ehajo/arcade-machine/Controller-Tennis/CAD/step/Unterteil.stp

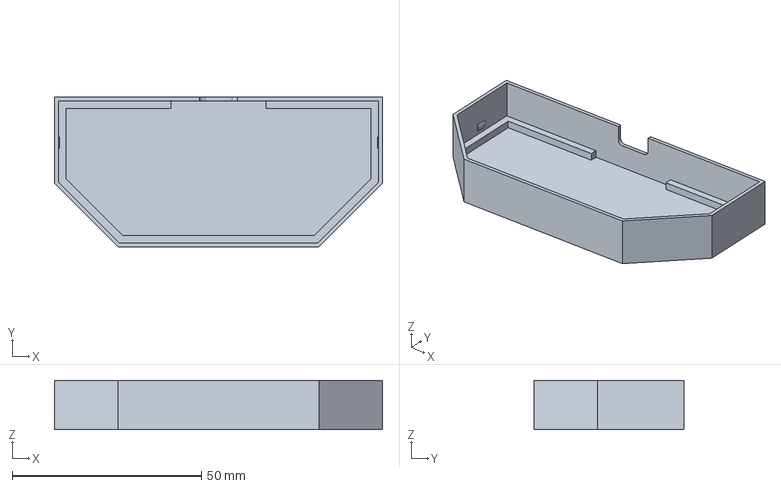
[picture p1: CAD file, 2026-05-15]
Controller-Tennis/CAD/step/Unterteil.stp
86.6 x 39.6 x 13.0 mm
