ehajo/arcade-machine/Controller-Tennis/PCB/controller-tennis/controller-tennis.step

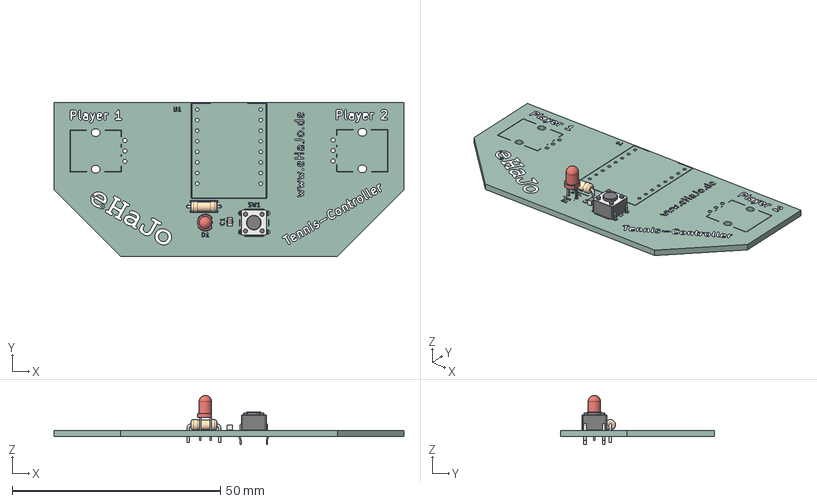
[picture p2: CAD file, 2026-02-06]
Controller-Tennis/PCB/controller-tennis/controller-tennis.step
84.0 x 37.0 x 11.8 mm
R_Axial_DIN0207_L6.3mm_D2.5mm_P7.62mm_Horizontal
C_0805_2012Metric
SW_PUSH_6mm
LED_D3.0mm
controller-tennis_silkscreen
controller-tennis_PCB
