ehajo/arcade-machine/Machine/CAD/step/Arcade.3mf

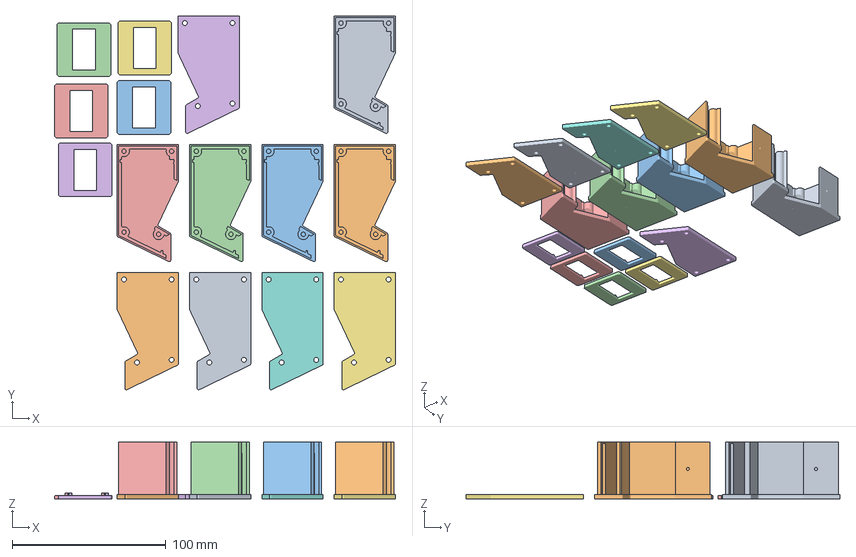
[picture p3: CAD file, 2026-05-20]
Machine/CAD/step/Arcade.3mf
222.1 x 243.4 x 37.0 mm
Arcade_base.stp x 5
Arcade_right.stp x 5
Bildschirm.stp x 5
