ehajo/arcade-machine/Controller-Tennis/CAD/step/knob.stp

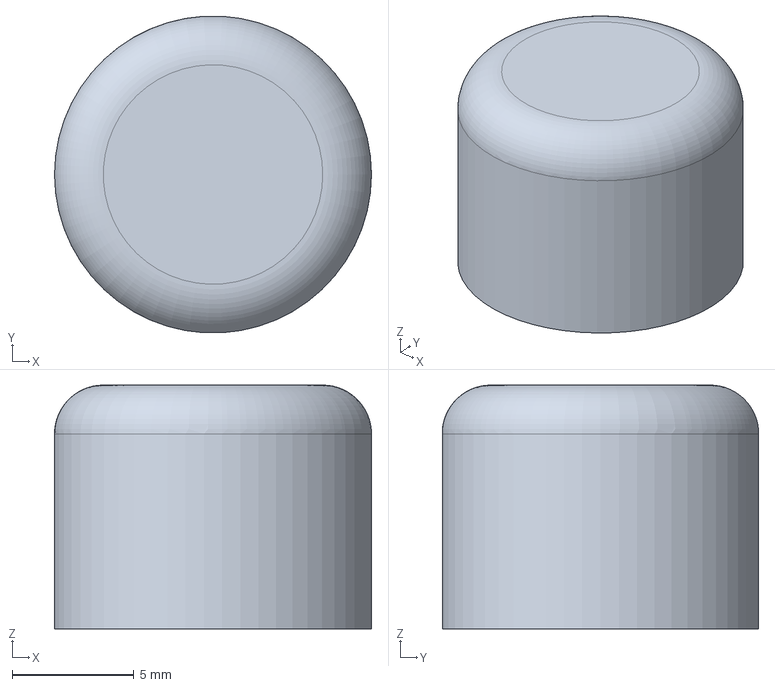
[picture p4: CAD file, 2026-05-15]
Controller-Tennis/CAD/step/knob.stp
13.0 x 13.0 x 10.0 mm
