ehajo/arcade-machine/Machine/CAD/step/Arcade_right.stp

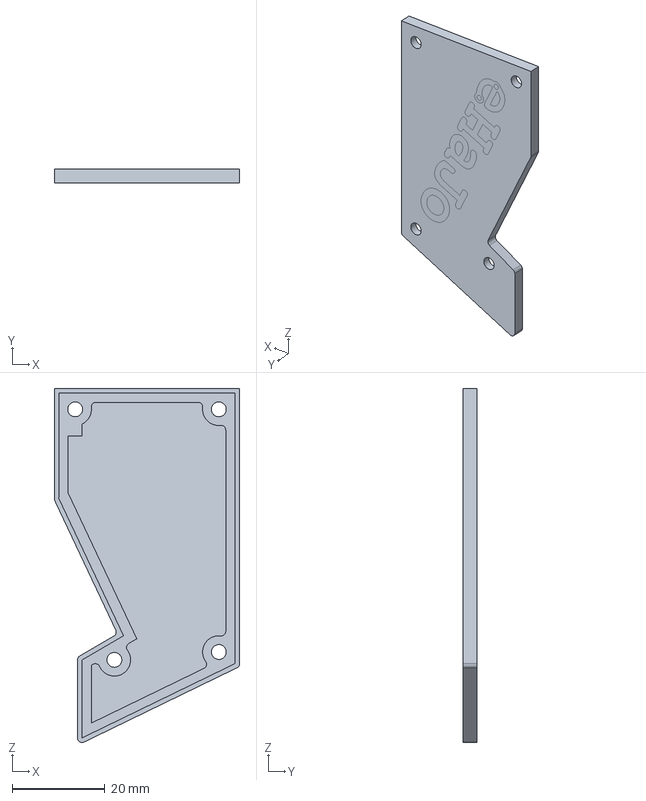
[picture p5: CAD file, 2026-05-15]
Machine/CAD/step/Arcade_right.stp
40.0 x 3.00 x 76.4 mm
