ehajo/arcade-machine/Controller-Tennis/CAD/step/Deckel.stp

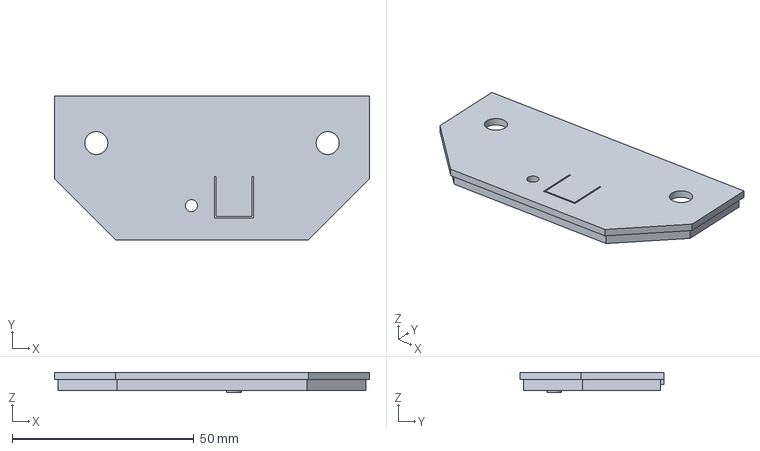
[picture p6: CAD file, 2026-05-15]
Controller-Tennis/CAD/step/Deckel.stp
86.6 x 39.6 x 5.60 mm
