ehajo/arcade-machine/Machine/CAD/step/Bildschirm.stp

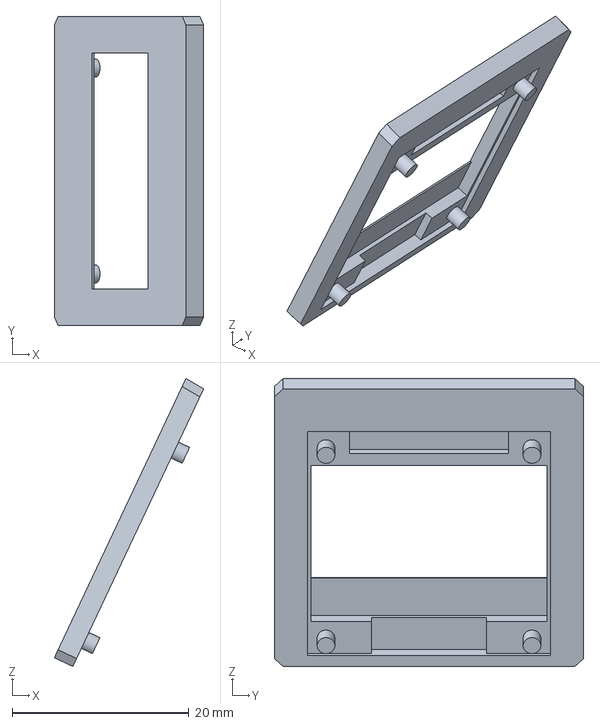
[picture p7: CAD file, 2026-05-15]
Machine/CAD/step/Bildschirm.stp
16.9 x 35.0 x 32.6 mm
