ehajo/arcade-machine/Controller-Tennis/CAD/step/tennis.3mf

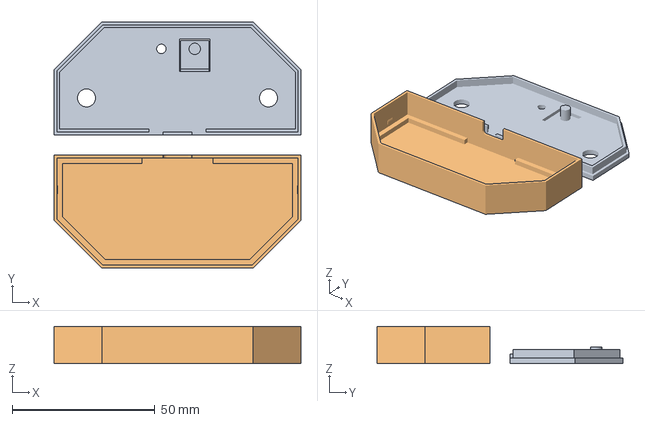
[picture p8: CAD file, 2026-05-15]
Controller-Tennis/CAD/step/tennis.3mf
86.6 x 86.3 x 13.0 mm
Deckel.stp
Unterteil.stp
