ehajo/arcade-machine/Machine/CAD/step/Arcade_base.stp

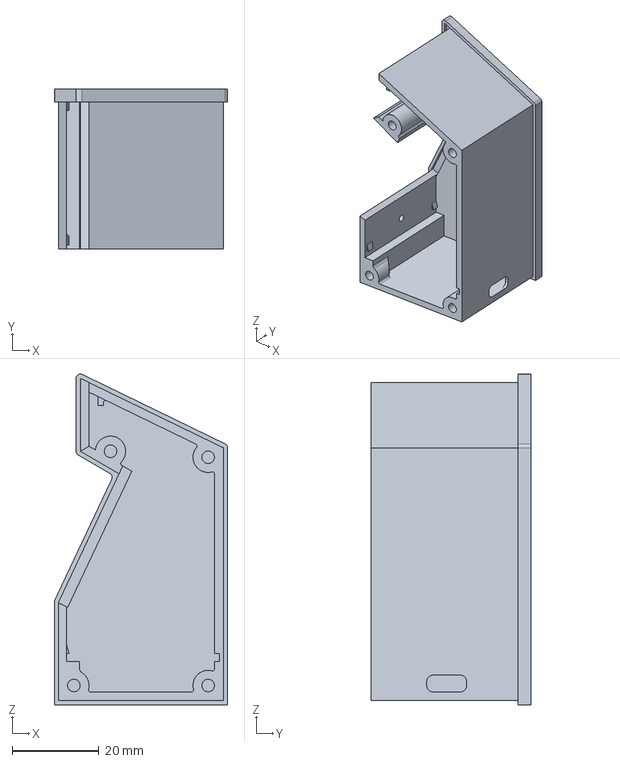
[picture p9: CAD file, 2026-05-15]
Machine/CAD/step/Arcade_base.stp
40.0 x 37.0 x 76.4 mm
