ehajo/arcade-machine/Machine/CAD/step/Beschriftung_blank.stp

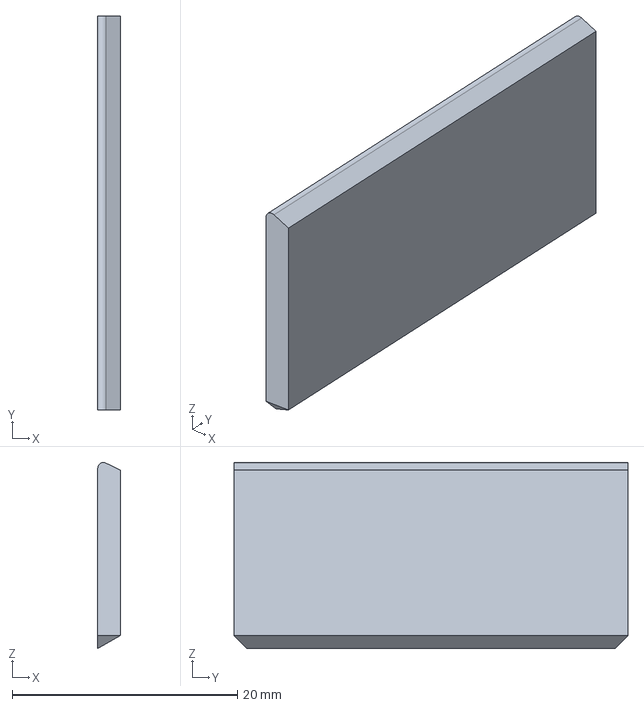
[picture p10: CAD file, 2026-05-15]
Machine/CAD/step/Beschriftung_blank.stp
2.00 x 35.0 x 16.5 mm
