ehajo/arcade-machine/Machine/CAD/step/Beschriftung.stp

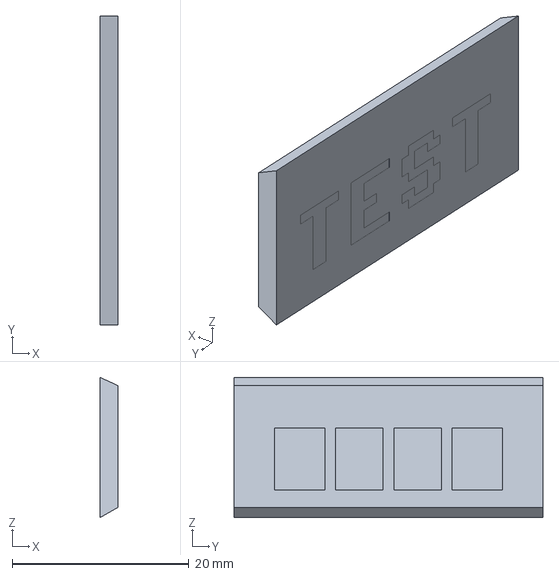
[picture p11: CAD file, 2026-02-06]
Machine/CAD/step/Beschriftung.stp
2.00 x 35.0 x 15.9 mm
