ehajo/arcade-machine/Machine/CAD/step/Beschriftung_test.stp

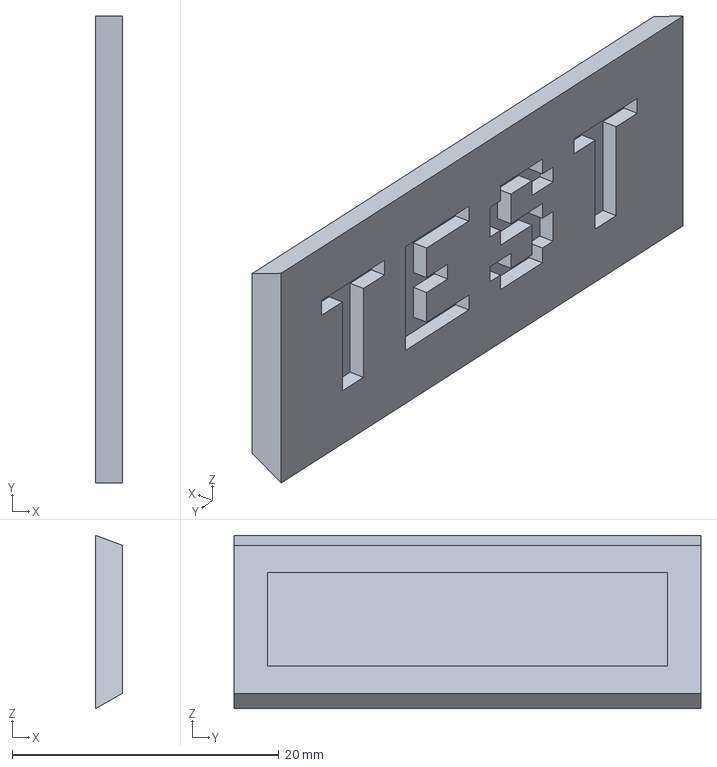
[picture p12: CAD file, 2026-02-06]
Machine/CAD/step/Beschriftung_test.stp
2.00 x 35.0 x 13.0 mm
