ehajo/arcade-machine/(list of files, cad)

Other CAD files:
Machine/CAD/step/Beschriftung_HaJo.stp
Machine/CAD/step/Beschriftung_ehajo.stp
Machine/CAD/step/Beschriftung_p1p2.stp
Machine/CAD/step/Beschriftung_diffus.stp
Machine/CAD/step/Beschriftung_ePNG.stp
Machine/CAD/step/Beschriftung_GNOP.stp
