ehajo/arcade-machine/Machine/PCB/arcade-pcb/arcade-pcb.kicad_pcb

## KiCad design Machine/PCB/arcade-pcb/arcade-pcb.kicad_pcb (2026-05-15)

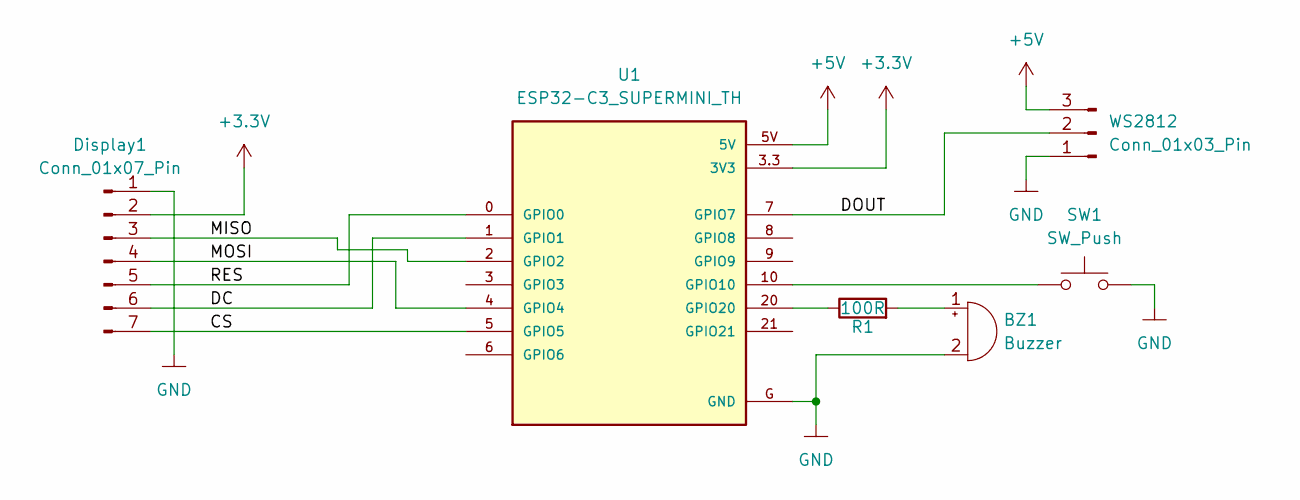
[picture p13: schematic arcade-pcb.kicad_sch]

Parts:
BZ1: Buzzer; Buzzer_12x9.5RM7.6
Display1: Conn_01x07_Pin; PinHeader_1x07_P1.27mm_Vertical_hand
R1: 100R; R_Axial_DIN0207_L6.3mm_D2.5mm_P7.62mm_Horizontal
SW1: SW_Push; SW_Tactile_SPST_Angled_PTS645Vx39-2LFS
U1: ESP32-C3_SUPERMINI_TH; MODULE_ESP32-C3_SUPERMINI_SMD
WS2812: Conn_01x03_Pin; PinHeader_1x03_P2.54mm_Vertical

Connections:
+3.3V: Display1.2, U1.3.3 (3V3)
+5V: U1.5V, WS2812.3
/CS: Display1.7, U1.5 (GPIO5)
/DC: Display1.6, U1.1 (GPIO1)
/DOUT: U1.7 (GPIO7), WS2812.2
/MISO: Display1.3, U1.2 (GPIO2)
/MOSI: Display1.4, U1.4 (GPIO4)
/RES: Display1.5, U1.0 (GPIO0)
GND: BZ1.2 (-), Display1.1, SW1.2, U1.G (GND), WS2812.1
unnamed: BZ1.1 (+), R1.2
unnamed: SW1.1, U1.10 (GPIO10)
unnamed: R1.1, U1.20 (GPIO20)

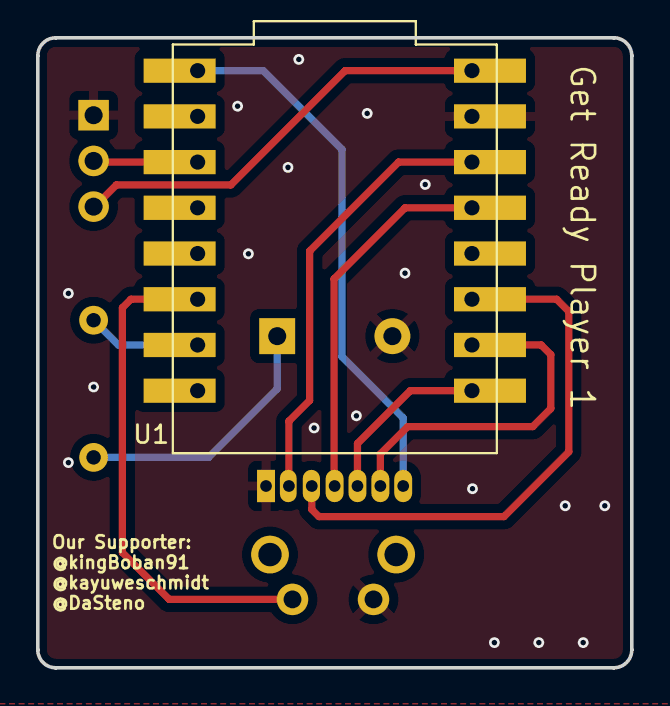
[picture p14: board arcade-pcb.kicad_pcb from above]

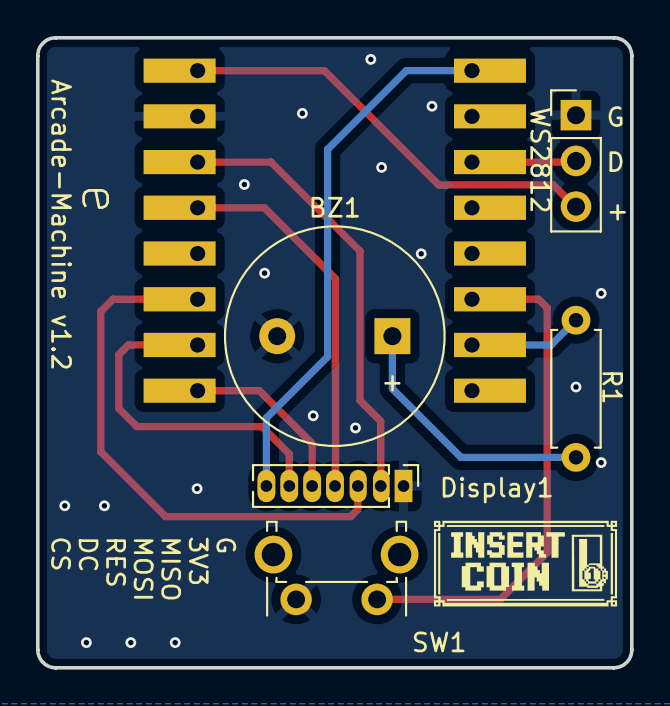
[picture p15: board arcade-pcb.kicad_pcb from below]

Board: 2 copper layers, 33.0 x 35.0 mm, 6 parts (5 on the bottom side), 12 nets.
