ehajo/arcade-machine/Controller-Standard/PCB/controller-standard/controller-standard.kicad_pcb

## KiCad design Controller-Standard/PCB/controller-standard/controller-standard.kicad_pcb (2026-03-03)

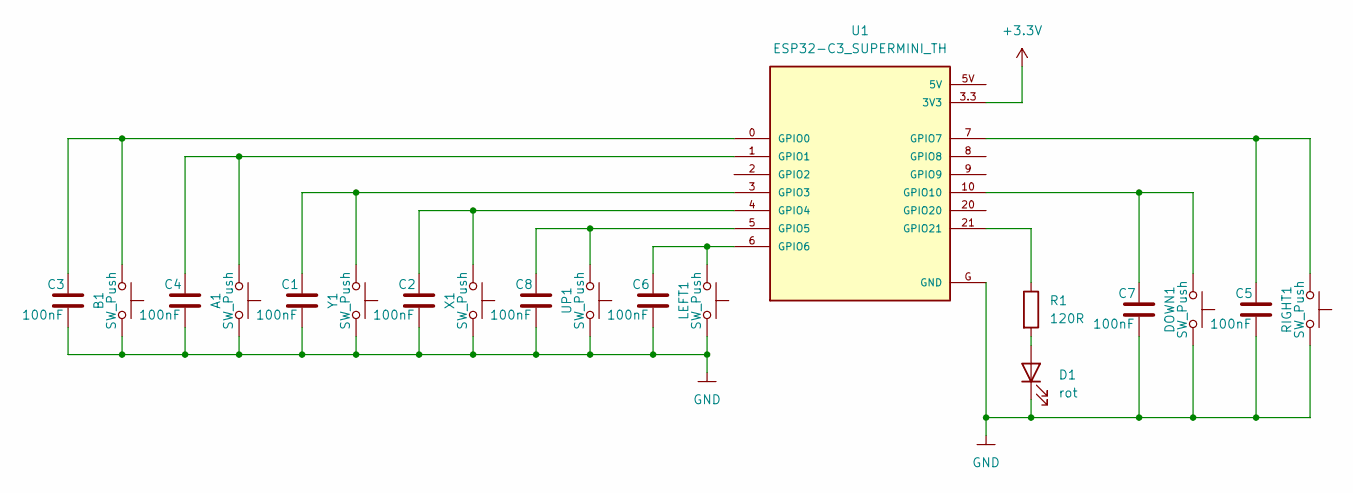
[picture p16: schematic controller-standard.kicad_sch]

Parts:
A1: SW_Push; SW_PUSH_6mm_H5mm
B1: SW_Push; SW_PUSH_6mm_H5mm
C1, C2, C3, C4, C5, C6, C7, C8: 100nF; C_0805_2012Metric_Pad1.18x1.45mm_HandSolder
D1: rot; LED_D3.0mm
DOWN1: SW_Push; SW_PUSH_6mm_H5mm
LEFT1: SW_Push; SW_PUSH_6mm_H5mm
R1: 120R; R_Axial_DIN0207_L6.3mm_D2.5mm_P7.62mm_Horizontal
RIGHT1: SW_Push; SW_PUSH_6mm_H5mm
U1: ESP32-C3_SUPERMINI_TH; MODULE_ESP32-C3_SUPERMINI_SMD
UP1: SW_Push; SW_PUSH_6mm_H5mm
X1: SW_Push; SW_PUSH_6mm_H5mm
Y1: SW_Push; SW_PUSH_6mm_H5mm

Connections:
+3.3V: U1.3.3 (3V3)
GND: A1.2, B1.2, C1.2, C2.2, C3.2, C4.2, C5.2, C6.2, C7.2, C8.2, D1.1 (K), DOWN1.2, LEFT1.2, RIGHT1.2, U1.G (GND), UP1.2, X1.2, Y1.2
unnamed: D1.2 (A), R1.2
unnamed: B1.1, C3.1, U1.0 (GPIO0)
unnamed: A1.1, C4.1, U1.1 (GPIO1)
unnamed: C1.1, U1.3 (GPIO3), Y1.1
unnamed: C2.1, U1.4 (GPIO4), X1.1
unnamed: C8.1, U1.5 (GPIO5), UP1.1
unnamed: C6.1, LEFT1.1, U1.6 (GPIO6)
unnamed: C5.1, RIGHT1.1, U1.7 (GPIO7)
unnamed: C7.1, DOWN1.1, U1.10 (GPIO10)
unnamed: R1.1, U1.21 (GPIO21)

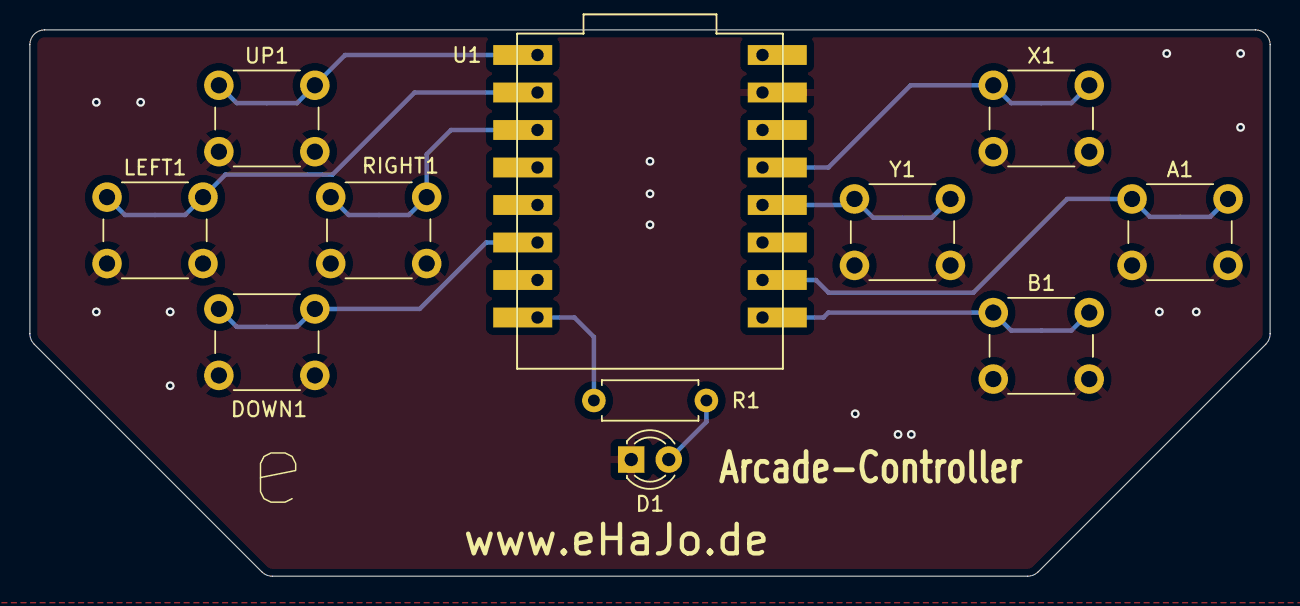
[picture p17: board controller-standard.kicad_pcb from above]

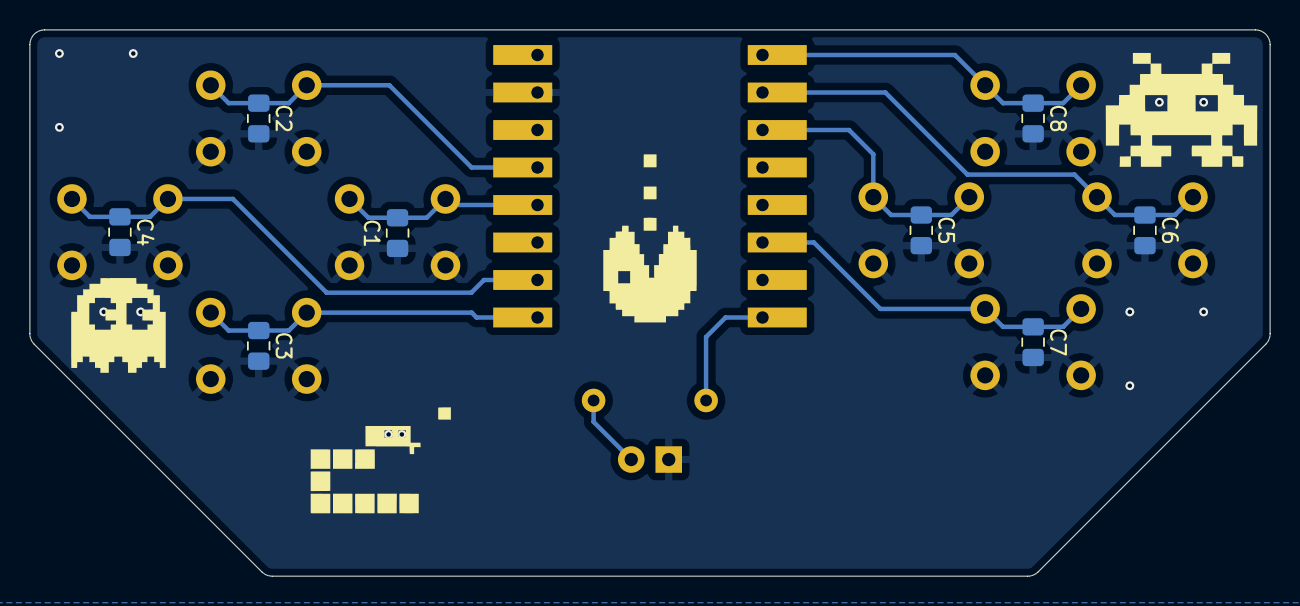
[picture p18: board controller-standard.kicad_pcb from below]

Board: 2 copper layers, 84.0 x 37.0 mm, 19 parts (8 on the bottom side), 11 nets.
