ehajo/arcade-machine/Controller-Tennis/PCB/controller-tennis/controller-tennis.kicad_pcb

## KiCad design Controller-Tennis/PCB/controller-tennis/controller-tennis.kicad_pcb (2026-03-03)

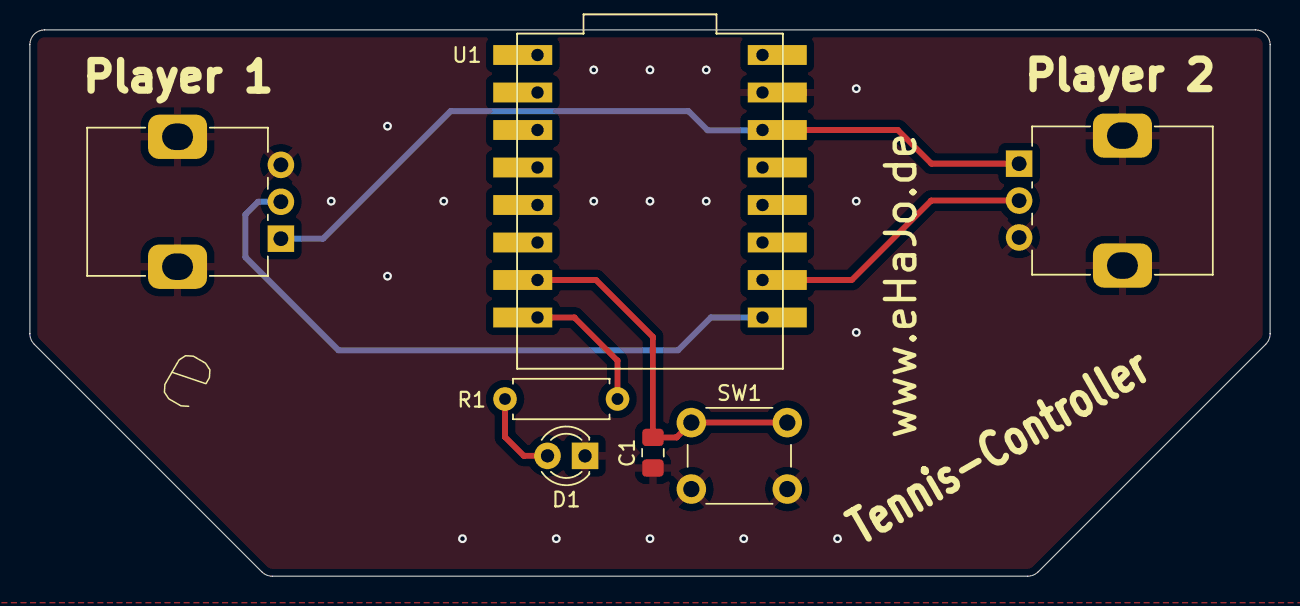
[picture p19: board controller-tennis.kicad_pcb from above]

Board: 2 copper layers, 84.0 x 37.0 mm, 7 parts (0 on the bottom side), 7 nets.

Parts:
C1: 100nF; C_0805_2012Metric_Pad1.18x1.45mm_HandSolder
D1: rot; LED_D3.0mm
Player 1, Player 2: 10k; Potentiometer_Alps_RK09K_Single_Vertical
R1: 120R; R_Axial_DIN0207_L6.3mm_D2.5mm_P7.62mm_Horizontal
SW1: SW_Push; SW_PUSH_6mm
U1: ESP32-C3_SUPERMINI_TH; MODULE_ESP32-C3_SUPERMINI_SMD

Connections:
+3.3V: Player 1.1, Player 2.1, U1.3.3 (3V3)
GND: C1.2, D1.1 (K), Player 1.3, Player 1.MP (MountPin), Player 2.3, Player 2.MP (MountPin), SW1.2, U1.G (GND)
unnamed: D1.2 (A), R1.2
unnamed: Player 1.2, U1.0 (GPIO0)
unnamed: Player 2.2, U1.1 (GPIO1)
unnamed: C1.1, SW1.1, U1.20 (GPIO20)
unnamed: R1.1, U1.21 (GPIO21)
