ehajo/arcade-machine/Machine/Software/elektronik-attack/elektronik-attack.ino

#include <Arduino.h>
#include <stdint.h>
#include <math.h>
#include <string.h>

#include <SPI.h>
#include <Adafruit_GFX.h>
#include <Adafruit_SSD1306.h>
#include <Adafruit_NeoPixel.h>

// ====================== ESP-NOW / PAIRING ======================
#include "ehajo_master.h"

// -------------------- PINS (wie bei euch) --------------------
#define SCREEN_WIDTH 128
#define SCREEN_HEIGHT 64
#define OLED_MOSI 4
#define OLED_CLK  2
#define OLED_DC   1
#define OLED_CS   5
#define OLED_RST  0

#define MASTER_PAIR_PIN 10

#define LED_PIN    7
#define NUM_LEDS   4
#define BUZZER_PIN  20

#define ALIEN_TYPES ENEMY_SPRITE_COUNT

Adafruit_SSD1306 display(SCREEN_WIDTH, SCREEN_HEIGHT, &SPI, OLED_DC, OLED_RST, OLED_CS);

// ====================== ELECTRONICS ATTACK SPRITE PACK ======================
// 8x8 schematic-symbol enemies

const uint8_t SPR_RESISTOR[] PROGMEM = {
0b00000000,
0b00111100,
0b11100111,
0b00111100,
0b00000000
};

const uint8_t SPR_CAPACITOR[] PROGMEM = {
0b00100100,
0b00100100,
0b11100111,
0b00100100,
0b00100100
};

const uint8_t SPR_DIODE[] PROGMEM = {
0b01000100,
0b01110100,
0b11111111,
0b01110100,
0b01000100
};

const uint8_t SPR_COIL[] PROGMEM = {
0b00000000,
0b00111100,
0b11111111,
0b00111100,
0b00000000
};

const uint8_t SPR_IC[] PROGMEM = {
0b10101010,
0b11111111,
0b10000001,
0b11111111,
0b10101010
};


// player soldering iron
const uint8_t SPR_SOLDERING_IRON[] PROGMEM = {
0b11111100,
0b11111110,
0b11111110,
0b00011111,
0b00001111,
0b00000111,
0b00000011,
0b00000001
};

// player projectile (solder)
const uint8_t SPR_SOLDER[] PROGMEM = {
0b00011000,
0b00011000,
0b00011000,
0b00011000
};

// enemy projectile (electron)
const uint8_t SPR_ELECTRON[] PROGMEM = {
0b00111100,
0b00100100,
0b00111100
};

const uint8_t* ENEMY_SPRITES[] = {
SPR_RESISTOR,
SPR_CAPACITOR,
SPR_DIODE,
SPR_COIL,
SPR_IC
};

const uint8_t ENEMY_SPRITE_COUNT = 5;

// ============================================================================

Adafruit_NeoPixel strip(NUM_LEDS, LED_PIN, NEO_GRB + NEO_KHZ800);

// ====================== SOUND (non-blocking, ESP32 Core 3.x) ======================
static const int      BUZZER_RES_BITS = 10;
static const uint32_t BUZZER_INIT_HZ  = 2000;
static const uint8_t  BUZZER_VOL_MAX  = 235;
static const uint8_t  BUZZER_VOL_MID  = 190;
static const uint8_t  BUZZER_VOL_LOW  = 130;

struct ToneStep {
  uint16_t hz;
  uint16_t ms;
  uint8_t  vol;
};

enum SfxId : uint8_t {
  SFX_NONE = 0,
  SFX_SHOOT,
  SFX_ALIEN_HIT,
  SFX_PLAYER_HIT,
  SFX_LEVEL_CLEAR,
  SFX_GAME_OVER,
  SFX_WIN
};

static const ToneStep SND_SHOOT[] = {
  {2800, 10, BUZZER_VOL_MAX},
  {1800, 22, BUZZER_VOL_MID},
  { 900, 18, BUZZER_VOL_LOW},
};

static const ToneStep SND_ALIEN_HIT[] = {
  {1800, 18, BUZZER_VOL_MAX},
  {1300, 18, BUZZER_VOL_MID},
  { 900, 22, BUZZER_VOL_LOW},
};

static const ToneStep SND_PLAYER_HIT[] = {
  { 420, 60, BUZZER_VOL_MAX},
  { 260, 90, BUZZER_VOL_MID},
  { 120, 90, BUZZER_VOL_LOW},
};

static const ToneStep SND_LEVEL_CLEAR[] = {
  { 784, 60, BUZZER_VOL_MID},
  { 988, 60, BUZZER_VOL_MID},
  {1319, 80, BUZZER_VOL_MAX},
  {1568, 120, BUZZER_VOL_MAX},
};

static const ToneStep SND_GAME_OVER[] = {
  { 659, 90, BUZZER_VOL_MID},
  { 494, 90, BUZZER_VOL_MID},
  { 330, 130, BUZZER_VOL_MID},
  { 196, 180, BUZZER_VOL_LOW},
};

static const ToneStep SND_WIN[] = {
  {1046, 60, BUZZER_VOL_MAX},
  {1319, 60, BUZZER_VOL_MAX},
  {1568, 60, BUZZER_VOL_MAX},
  {2093, 160, BUZZER_VOL_MAX},
};

struct SoundState {
  const ToneStep* seq = nullptr;
  uint8_t len = 0;
  uint8_t idx = 0;
  bool active = false;
  uint32_t stepUntil = 0;
} snd;

static void attachBuzzerOnce() {
  static bool attached = false;
  if (attached) return;

  int ch = ledcAttach(BUZZER_PIN, BUZZER_INIT_HZ, BUZZER_RES_BITS);
  Serial.printf("[AUDIO] ledcAttach() -> channel=%d\n", ch);
  if (ch < 0) {
    Serial.println("[AUDIO] ERROR: LEDC attach failed");
    return;
  }
  ledcWrite(BUZZER_PIN, 0);
  attached = true;
}

static inline void buzzerOff() {
  ledcWrite(BUZZER_PIN, 0);
}

static inline void buzzerOn(uint32_t hz, uint8_t vol) {
  if (hz < 20) hz = 20;
  ledcWriteTone(BUZZER_PIN, hz);

  uint32_t maxDuty = (1UL << BUZZER_RES_BITS) - 1;
  uint32_t duty = (uint32_t)((vol / 255.0f) * maxDuty);
  ledcWrite(BUZZER_PIN, duty);
}

static void playSfx(const ToneStep* seq, uint8_t len) {
  if (!seq || len == 0) {
    snd.active = false;
    snd.seq = nullptr;
    snd.len = 0;
    snd.idx = 0;
    snd.stepUntil = 0;
    buzzerOff();
    return;
  }

  snd.seq = seq;
  snd.len = len;
  snd.idx = 0;
  snd.active = true;
  snd.stepUntil = 0;
}

static void playSfxId(SfxId id) {
  switch (id) {
    case SFX_SHOOT:       playSfx(SND_SHOOT,       sizeof(SND_SHOOT) / sizeof(SND_SHOOT[0])); break;
    case SFX_ALIEN_HIT:   playSfx(SND_ALIEN_HIT,   sizeof(SND_ALIEN_HIT) / sizeof(SND_ALIEN_HIT[0])); break;
    case SFX_PLAYER_HIT:  playSfx(SND_PLAYER_HIT,  sizeof(SND_PLAYER_HIT) / sizeof(SND_PLAYER_HIT[0])); break;
    case SFX_LEVEL_CLEAR: playSfx(SND_LEVEL_CLEAR, sizeof(SND_LEVEL_CLEAR) / sizeof(SND_LEVEL_CLEAR[0])); break;
    case SFX_GAME_OVER:   playSfx(SND_GAME_OVER,   sizeof(SND_GAME_OVER) / sizeof(SND_GAME_OVER[0])); break;
    case SFX_WIN:         playSfx(SND_WIN,         sizeof(SND_WIN) / sizeof(SND_WIN[0])); break;
    default:              buzzerOff(); snd.active = false; break;
  }
}

static void updateSound(uint32_t now) {
  if (!snd.active || !snd.seq || snd.len == 0) return;

  if (snd.stepUntil != 0 && now < snd.stepUntil) return;

  if (snd.idx >= snd.len) {
    snd.active = false;
    buzzerOff();
    return;
  }

  const ToneStep &s = snd.seq[snd.idx++];
  if (s.hz == 0 || s.vol == 0) buzzerOff();
  else buzzerOn(s.hz, s.vol);

  snd.stepUntil = now + s.ms;
}

// ====================== Pairing Display Callback ======================
// Wird von pairingLoop() in ehajo_master.h aufgerufen
static void pairingDisplay(uint32_t now) {
  display.clearDisplay();
  display.setTextSize(1);
  display.setTextColor(SSD1306_WHITE);
  display.setCursor(18, 0); display.print("PAIRING MODE");

  char macStr[18];
  snprintf(macStr, sizeof(macStr), "%02X:%02X:%02X:%02X:%02X:%02X",
           g_mac[0], g_mac[1], g_mac[2], g_mac[3], g_mac[4], g_mac[5]);
  display.setCursor(0, 14); display.print("MAC:");
  display.setCursor(0, 24); display.print(macStr);

  display.setCursor(0, 38); display.print("Waiting for Ctrl...");
  display.display();

  strip.clear();
  for (int k=0;k<NUM_LEDS;k++)
    strip.setPixelColor(k, ((now/200)%2) ? strip.Color(40,40,0) : strip.Color(0,0,0));
  strip.show();
}

static const uint32_t PAIR_LONGPRESS_MS = 1500;

// ====================== GAME: Alien Angriff =================
static const int TOP_UI_H  = 12;
static const int FIELD_Y0  = TOP_UI_H + 1;
static const int FIELD_Y1  = SCREEN_HEIGHT - 1;

static const uint8_t BTN_FIRE = 0x01;

// BULLETS: sichtbar + langsam
static const int BULLET_W = 1;
static const int BULLET_H = 2;

// Bewegungstakt fuer Bullets (je hoeher, desto langsamer)
static const uint32_t BULLET_TICK_MS = 20;

// Rendering-Update (fps)
static const uint32_t DISPLAY_TICK_MS = 33;   // ~30 fps
static const uint32_t LED_TICK_MS     = 33;

enum GameMode { MODE_IDLE, MODE_RUNNING, MODE_GAMEOVER, MODE_WIN };

struct Bullet {
  int16_t x, y;
  int8_t  vy;           // Pixel pro Bullet-Tick
  bool active;
  bool fromPlayer;
};

static const int MAX_BULLETS = 10;
Bullet bullets[MAX_BULLETS];

// ---------- WIN / FIREWORKS ----------
struct Spark {
  int16_t x16, y16;   // position in 1/16 pixel units
  int16_t vx16, vy16; // velocity in 1/16 pixel units per tick
  uint8_t life;       // ticks remaining
  bool active;
};

static const uint8_t MAX_SPARKS = 24;
static Spark sparks[MAX_SPARKS];
static uint32_t g_nextWinTick = 0;
static uint32_t g_nextBurstMs = 0;

static void clearSparks(){
  for(int i=0;i<MAX_SPARKS;i++) sparks[i].active = false;
}

static void spawnBurst(){
  int cx = random(18, SCREEN_WIDTH-18);
  int cy = random(FIELD_Y0+6, 42);

  for(int i=0;i<MAX_SPARKS;i++){
    sparks[i].active = true;
    sparks[i].x16 = (int16_t)(cx*16);
    sparks[i].y16 = (int16_t)(cy*16);

    int vx = (int)random(-32, 33);
    int vy = (int)random(-32, 33);
    if(abs(vx) < 6) vx = (vx < 0) ? -6 : 6;
    if(abs(vy) < 6) vy = (vy < 0) ? -6 : 6;

    sparks[i].vx16 = (int16_t)vx;
    sparks[i].vy16 = (int16_t)vy;

    sparks[i].life = (uint8_t)random(14, 28);
  }
}

static const int SHIP_W = 9;
static const int SHIP_H = 4;

// Elektronik-Bauteile: nur 2 Reihen, mehr Abstand
static const int ALIEN_COLS = 7;
static const int ALIEN_ROWS = 2;

static const int ALIEN_W = 8;
static const int ALIEN_H = 5;
static const int ALIEN_SPX = 6;
static const int ALIEN_SPY = 5;
static const int ALIEN_START_X = 8;
static const int ALIEN_START_Y = FIELD_Y0 + 1; // hoeher starten
static uint8_t rowAlienType[ALIEN_ROWS] = {0};

struct Alien { bool alive; };
Alien aliens[ALIEN_ROWS][ALIEN_COLS];

struct GameState {
  GameMode mode = MODE_IDLE;

  int16_t shipX = (SCREEN_WIDTH - SHIP_W)/2;
  int16_t shipY = FIELD_Y1 - SHIP_H;

  int16_t aliensOffX = 0, aliensOffY = 0;
  int8_t  aliensDir = 1;
  uint32_t aliensStepMs = 520;           // etwas langsamer starten
  uint32_t nextAliensStep = 0;

  uint32_t nextPlayerShot = 0;
  uint32_t nextEnemyShot  = 0;

  uint16_t score = 0;
  int8_t lives = 3;

  uint16_t level = 1;

  // WIN screen timing
  uint32_t winStartMs = 0;

  uint8_t prevButtons = 0;
  uint32_t hitFlashUntil = 0;
} gs;

// Ticker
static uint32_t g_nextBulletStep = 0;

static inline bool rectHit(int ax,int ay,int aw,int ah,int bx,int by,int bw,int bh){
  return !(ax+aw<=bx || bx+bw<=ax || ay+ah<=by || by+bh<=ay);
}

static void resetAliens(){
  for(int r=0;r<ALIEN_ROWS;r++) for(int c=0;c<ALIEN_COLS;c++) aliens[r][c].alive=true;
  gs.aliensOffX=0; gs.aliensOffY=0; gs.aliensDir=1;

  // pro Level zufaellige Bauteil-Typen je Zeile (und moeglichst nicht doppelt)
  for(int r=0;r<ALIEN_ROWS;r++){
    uint8_t t = (uint8_t)random(ENEMY_SPRITE_COUNT);
    if(r>0 && ENEMY_SPRITE_COUNT>1){
      while(t == rowAlienType[r-1]) t = (uint8_t)random(ALIEN_TYPES);
    }
    rowAlienType[r] = t;
  }

  // Aliens werden pro Level etwas schneller
  // Level 1: 520ms, danach -40ms pro Level, aber nicht schneller als 180ms
  int step = 520 - (int)(gs.level - 1) * 40;
  if(step < 180) step = 180;
  gs.aliensStepMs=(uint32_t)step;

  gs.nextAliensStep=millis()+gs.aliensStepMs;
}

static void resetBullets(){
  for(int i=0;i<MAX_BULLETS;i++) bullets[i].active=false;
}

static void newGame(){
  gs.mode=MODE_RUNNING; gs.score=0; gs.lives=3; gs.level=1;
  gs.shipX=(SCREEN_WIDTH-SHIP_W)/2; gs.shipY=FIELD_Y1-SHIP_H;
  gs.nextPlayerShot=millis(); gs.nextEnemyShot=millis()+900;
  gs.hitFlashUntil=0;
  resetAliens();
  resetBullets();
  g_nextBulletStep = millis() + BULLET_TICK_MS;
}

static void startWin(uint32_t now){
  gs.mode = MODE_WIN;
  gs.winStartMs = now;

  // stop anything in flight
  resetBullets();

  // fireworks
  clearSparks();
  g_nextWinTick = now;
  g_nextBurstMs = now;
  spawnBurst();
  playSfxId(SFX_WIN);
}

static void spawnBullet(int16_t x,int16_t y,int8_t vy,bool fromPlayer){
  for(int i=0;i<MAX_BULLETS;i++){
    if(!bullets[i].active){
      bullets[i].active=true;
      bullets[i].x=x;
      bullets[i].y=y;
      bullets[i].vy=vy;
      bullets[i].fromPlayer=fromPlayer;
      return;
    }
  }
}

static int aliveAliensCount(){
  int n=0;
  for(int r=0;r<ALIEN_ROWS;r++) for(int c=0;c<ALIEN_COLS;c++) if(aliens[r][c].alive) n++;
  return n;
}

static void updateShipFromPoti(){
  int tx = map((int)g_rxP1, 0, 4095, 0, SCREEN_WIDTH - SHIP_W);
  gs.shipX = (gs.shipX*3 + tx)/4;
}

static void updateAliens(uint32_t now){
  if(now < gs.nextAliensStep) return;
  gs.nextAliensStep = now + gs.aliensStepMs;

  int minCol=999,maxCol=-1,minRow=999,maxRow=-1;
  for(int r=0;r<ALIEN_ROWS;r++){
    for(int c=0;c<ALIEN_COLS;c++){
      if(!aliens[r][c].alive) continue;
      if(c<minCol) minCol=c; if(c>maxCol) maxCol=c;
      if(r<minRow) minRow=r; if(r>maxRow) maxRow=r;
    }
  }

  if(maxCol < 0){
    gs.level++;
    // geschafft!!! (freak!)
    if(gs.level >= 100){
      startWin(now);
      return;
    }
    playSfxId(SFX_LEVEL_CLEAR);
    // Level geschafft -> naechstes Level
    resetAliens();

    // Bullets fuer neues Level loeschen
    resetBullets();
    gs.nextPlayerShot = now;
    gs.nextEnemyShot  = now + 700;

    // Bullet-Ticker sauber neu starten
    g_nextBulletStep = now + BULLET_TICK_MS;
    return;
  }

  int blockX0 = ALIEN_START_X + gs.aliensOffX + minCol*(ALIEN_W+ALIEN_SPX);
  int blockX1 = ALIEN_START_X + gs.aliensOffX + maxCol*(ALIEN_W+ALIEN_SPX) + ALIEN_W;

  bool hitRight = (blockX1 >= SCREEN_WIDTH-2);
  bool hitLeft  = (blockX0 <= 2);

  if((gs.aliensDir>0 && hitRight) || (gs.aliensDir<0 && hitLeft)){
    gs.aliensDir *= -1;
    gs.aliensOffY += 2; // weniger runter pro bounce
  } else {
    gs.aliensOffX += gs.aliensDir * 2;
  }

  int blockY1 = ALIEN_START_Y + gs.aliensOffY + maxRow*(ALIEN_H+ALIEN_SPY) + ALIEN_H;
  if(blockY1 >= gs.shipY - 1) gs.mode = MODE_GAMEOVER;
}

static void updateBullets(uint32_t now){
  if (now < g_nextBulletStep) return;
  // catch-up, falls es laggt
  while (now >= g_nextBulletStep) g_nextBulletStep += BULLET_TICK_MS;

  for(int i=0;i<MAX_BULLETS;i++){
    if(!bullets[i].active) continue;

    bullets[i].y += bullets[i].vy;

    // Bounds: beruecksichtige Hoehe
    if(bullets[i].y + BULLET_H < FIELD_Y0 || bullets[i].y > FIELD_Y1){
      bullets[i].active=false;
      continue;
    }

    if(bullets[i].fromPlayer){
      for(int r=0;r<ALIEN_ROWS;r++){
        for(int c=0;c<ALIEN_COLS;c++){
          if(!aliens[r][c].alive) continue;
          int ax = ALIEN_START_X + gs.aliensOffX + c*(ALIEN_W+ALIEN_SPX);
          int ay = ALIEN_START_Y + gs.aliensOffY + r*(ALIEN_H+ALIEN_SPY);

          if(rectHit(bullets[i].x, bullets[i].y, BULLET_W, BULLET_H, ax, ay, ALIEN_W, ALIEN_H)){
            aliens[r][c].alive=false;
            bullets[i].active=false;
            gs.score += 10;
            playSfxId(SFX_ALIEN_HIT);

            int alive = aliveAliensCount();
            if(alive>0){
              uint32_t t = 200 + (alive*8);
              if(t < gs.aliensStepMs) gs.aliensStepMs = t;
            }
            break;
          }
        }
      }
    } else {
      if(rectHit(bullets[i].x, bullets[i].y, BULLET_W, BULLET_H, gs.shipX, gs.shipY, SHIP_W, SHIP_H)){
        bullets[i].active=false;
        gs.lives--;
        gs.hitFlashUntil=now+300;
        gs.shipX=(SCREEN_WIDTH-SHIP_W)/2;

        if(gs.lives <= 0){
          gs.mode=MODE_GAMEOVER;
          playSfxId(SFX_GAME_OVER);
        } else {
          playSfxId(SFX_PLAYER_HIT);
        }
      }
    }
  }
}

static bool anyEnemyBulletActive(){
  for (int i=0;i<MAX_BULLETS;i++){
    if (bullets[i].active && !bullets[i].fromPlayer) return true;
  }
  return false;
}


static void handleShooting(uint32_t now){
  uint8_t b = g_rxButtons;
  bool firePressed = (b & BTN_FIRE) && !(gs.prevButtons & BTN_FIRE);
  gs.prevButtons = b;

  if(gs.mode == MODE_IDLE){
    if(firePressed) newGame();
    return;
  }
  if(gs.mode == MODE_GAMEOVER){
    if(firePressed){
      gs.mode=MODE_IDLE;
      resetBullets();
    }
    return;
  }

  // Player shoot cooldown
  if(firePressed && now >= gs.nextPlayerShot){
    gs.nextPlayerShot = now + 240;
    // Langsam: -1 pro Bullet-Tick
    spawnBullet(gs.shipX + SHIP_W/2, gs.shipY - 2, -1, true);
    playSfxId(SFX_SHOOT);
  }

  // Enemy shots
  if(now >= gs.nextEnemyShot){
    gs.nextEnemyShot = now + (uint32_t)random(700, 1200);

    // nur 1 Alien-Schuss gleichzeitig
    if (anyEnemyBulletActive()) return;

    int tries=16;
    while(tries--){
      int c = random(0, ALIEN_COLS);
      int rHit=-1;
      for(int r=ALIEN_ROWS-1;r>=0;r--){
        if(aliens[r][c].alive){ rHit=r; break; }
      }
      if(rHit>=0){
        int ax = ALIEN_START_X + gs.aliensOffX + c*(ALIEN_W+ALIEN_SPX) + ALIEN_W/2;
        int ay = ALIEN_START_Y + gs.aliensOffY + rHit*(ALIEN_H+ALIEN_SPY) + ALIEN_H;
        spawnBullet(ax, ay+1, +1, false);
        break;
      }
    }
  }
}

// ====================== DRAWING ======================
static void drawUI(){
  display.setTextSize(1);
  display.setTextColor(SSD1306_WHITE);
  display.drawFastHLine(0, TOP_UI_H, SCREEN_WIDTH, SSD1306_WHITE);

  display.setCursor(0, 2);  display.print("S:"); display.print(gs.score);
  display.setCursor(52, 2); display.print("L:"); display.print((int)gs.lives);

  display.setCursor(92, 2); display.print("LV:"); display.print(gs.level);
}

static void drawShip(uint32_t now){
  if(now < gs.hitFlashUntil && ((now/60)%2)) return;

  // 9x4 Loetkolben-Sprite
  static const uint16_t solderingIron[SHIP_H] = {
    0b111111100, // Griff
    0b111111110, // Griff + Schaft
    0b001111111, // Schaft + Spitze
    0b000011110  // feine Spitze
  };

  for(int yy=0; yy<SHIP_H; yy++){
    uint16_t row = solderingIron[yy];
    for(int xx=0; xx<SHIP_W; xx++){
      if(row & (1U << (SHIP_W - 1 - xx))){
        display.drawPixel(gs.shipX + xx, gs.shipY + yy, SSD1306_WHITE);
      }
    }
  }

  // kleines Glimmen an der Spitze
  if(((now/180) & 1) == 0){
    display.drawPixel(gs.shipX + SHIP_W - 1, gs.shipY + 2, SSD1306_WHITE);
  }
}

static void drawAliens(){
  for(int r=0;r<ALIEN_ROWS;r++){
    uint8_t t = rowAlienType[r] % ENEMY_SPRITE_COUNT;

    for(int c=0;c<ALIEN_COLS;c++){
      if(!aliens[r][c].alive) continue;

      int ax = ALIEN_START_X + gs.aliensOffX + c*(ALIEN_W+ALIEN_SPX);
      int ay = ALIEN_START_Y + gs.aliensOffY + r*(ALIEN_H+ALIEN_SPY);

      const uint8_t* sprite = ENEMY_SPRITES[t % ENEMY_SPRITE_COUNT];

      display.drawBitmap(
        ax,
        ay,
        sprite,
        8,
        8,
        SSD1306_WHITE
      );
    }
  }
}

static void drawBullets(){
  for(int i=0;i<MAX_BULLETS;i++){
    if(!bullets[i].active) continue;

    int x = bullets[i].x;
    int y = bullets[i].y;

    if (x < 0) x = 0;
    if (x > SCREEN_WIDTH - BULLET_W) x = SCREEN_WIDTH - BULLET_W;

    display.drawBitmap(
      bullets[i].x,
      bullets[i].y,
      SPR_SOLDER,
      4,
      4,
      SSD1306_WHITE
    );
  }
}

static void drawStartScreen(uint32_t now){
  display.setTextSize(1);
  display.setTextColor(SSD1306_WHITE);
  display.setCursor(16, 18); display.print("Elektronik");
  display.setCursor(34, 28); display.print("Attack");
  if((now/500)%2){ display.setCursor(32, 48); display.print("PRESS FIRE"); }
}

static void drawGameOver(uint32_t now){
  display.setTextSize(1);
  display.setTextColor(SSD1306_WHITE);
  display.setCursor(34, 18); display.print("GAME OVER");
  display.setCursor(28, 34); display.print("SCORE: "); display.print(gs.score);
  if((now/500)%2){ display.setCursor(32, 48); display.print("PRESS FIRE"); }
}

// ===== WIN SCREEN (Level 100) =====
static void drawWin(uint32_t now){
  if(now >= g_nextWinTick){
    g_nextWinTick = now + 30;

    if(now >= g_nextBurstMs){
      g_nextBurstMs = now + (uint32_t)random(220, 520);
      spawnBurst();
    }

    for(int i=0;i<MAX_SPARKS;i++){
      if(!sparks[i].active) continue;

      sparks[i].vy16 += 2; // gravity

      sparks[i].x16 += sparks[i].vx16;
      sparks[i].y16 += sparks[i].vy16;

      if(sparks[i].life) sparks[i].life--;
      if(sparks[i].life == 0) sparks[i].active = false;

      int x = sparks[i].x16 / 16;
      int y = sparks[i].y16 / 16;
      if(x < 0 || x >= SCREEN_WIDTH || y < FIELD_Y0 || y >= SCREEN_HEIGHT){
        sparks[i].active = false;
      }
    }
  }

  display.clearDisplay();

  display.setTextColor(SSD1306_WHITE);
  display.setTextSize(1);
  display.setCursor(22, 0);
  display.print("LOETMEISTER!");

  for(int i=0;i<MAX_SPARKS;i++){
    if(!sparks[i].active) continue;
    int x = sparks[i].x16 / 16;
    int y = sparks[i].y16 / 16;
    display.drawPixel(x, y, SSD1306_WHITE);
    if(((now/60)&1) && y+1 < SCREEN_HEIGHT) display.drawPixel(x, y+1, SSD1306_WHITE);
  }

  if(((now/250)&1)==0){
    display.setTextSize(2);
    display.setCursor(50, 22);
    display.print("GG!");
    display.setTextSize(1);
    display.setCursor(8, 50);
    display.print("Hold Fire for Reset");
  }
}

static void updateLeds(uint32_t now){
  bool hitFlash = (now < gs.hitFlashUntil);

  for(int i=0;i<NUM_LEDS;i++){
    uint32_t col = strip.Color(0,0,0);

    if(hitFlash){
      col = ((now/70)%2) ? strip.Color(40,0,0) : strip.Color(0,0,0);
    } else if(gs.mode == MODE_RUNNING){
      col = (i < gs.lives) ? strip.Color(0,35,0) : strip.Color(0,0,0);
      if(i==3 && gs.score>0 && ((now/160)%2)) col = strip.Color(0,0,35);
    } else if(gs.mode == MODE_IDLE){
      uint8_t v = (uint8_t)(10 + 10 * (1.0f + sinf(now/600.0f))*0.5f);
      col = strip.Color(0,0,v);
    } else if(gs.mode == MODE_WIN){
      uint8_t r = (uint8_t)random(0, 255);
      uint8_t g = (uint8_t)random(0, 255);
      uint8_t b = (uint8_t)random(0, 255);
      col = strip.Color(r,g,b);
    } else {
      col = ((now/220)%2) ? strip.Color(35,0,0) : strip.Color(0,0,0);
    }

    strip.setPixelColor(i, col);
  }
  strip.show();
}

// ====================== SETUP/LOOP ======================
static uint32_t pairPressStart = 0;

void setup(){
  Serial.begin(115200);
  delay(50);

  SPI.begin(OLED_CLK, -1, OLED_MOSI, OLED_CS);
  display.begin(SSD1306_SWITCHCAPVCC);
  display.setTextColor(SSD1306_WHITE);
  display.setRotation(2);   // OLED um 180 Grad drehen

  strip.begin();
  strip.setBrightness(255);
  strip.show();

  pinMode(MASTER_PAIR_PIN, INPUT_PULLUP);
  randomSeed((uint32_t)esp_random());
  attachBuzzerOnce();

  // --- STA-Mode (funktioniert fuer Empfang auf Machine) ---
  WiFi.mode(WIFI_STA);
  WiFi.disconnect(false, true);
  WiFi.setAutoReconnect(false);
  WiFi.setSleep(false);
  delay(500);

  wifiTweak();

  esp_read_mac(g_mac, ESP_MAC_WIFI_STA);
  Serial.printf("[ARCADE] STA MAC %02X:%02X:%02X:%02X:%02X:%02X\n",
    g_mac[0],g_mac[1],g_mac[2],g_mac[3],g_mac[4],g_mac[5]);
  Serial.printf("[ARCADE] WiFi.status=%d mode=%d\n", (int)WiFi.status(), (int)WiFi.getMode());

  if (esp_now_init() != ESP_OK) {
    display.clearDisplay();
    display.setCursor(0,0);
    display.print("esp_now_init FAIL");
    display.display();
    while(true){ delay(1000); }
  }
  Serial.println("[ARCADE] ESP-NOW init OK");

  // Channel NACH esp_now_init setzen
  forceChannel1();

  esp_now_register_recv_cb(onDataRecv);

  Serial.println("[ARCADE] Elektronik Attack master boot");
  g_autoPairUntil = millis() + 20000; // 20s Auto-Pair Fenster nach Boot

  gs.mode = MODE_IDLE;
  resetBullets();
  resetAliens();
  g_nextBulletStep = millis() + BULLET_TICK_MS;
}

void loop(){
  uint32_t now = millis();
  updateSound(now);

  // Auto-Pairing kurz nach Boot, solange noch kein Controller aktiv ist
  if (!ctrlPeerAdded && !g_pairing && (g_autoPairUntil != 0) && (now < g_autoPairUntil)) {
    startPairing();
  }

  // Long press -> Pairing Mode (Arcade)
  if (digitalRead(MASTER_PAIR_PIN) == LOW) {
    if (pairPressStart == 0) pairPressStart = now;
    if (!g_pairing && (now - pairPressStart) > PAIR_LONGPRESS_MS) {
      startPairing();
    }
  } else {
    pairPressStart = 0;
  }

  if (g_pairing) {
    pairingLoop();
    return;
  }

  // LEDs
  static uint32_t lastLed = 0;
  if(now - lastLed >= LED_TICK_MS){
    lastLed = now;
    updateLeds(now);
  }

  // --- WIN MODE: 2s FIRE halten fuer Neustart ---
  static uint32_t winFirePressStart = 0;

  if(gs.mode == MODE_WIN){

    bool firePressed = (g_rxButtons & BTN_FIRE);

    if(firePressed){
      if(winFirePressStart == 0){
        winFirePressStart = now;   // Zeit merken
      }

      // 2 Sekunden gehalten?
      if(now - winFirePressStart > 1000){
        winFirePressStart = 0;
        newGame();
      }
    } else {
      // Taste losgelassen -> Reset Timer
      winFirePressStart = 0;
    }

    gs.prevButtons = g_rxButtons;
  } else {
    updateShipFromPoti();
    handleShooting(now);
  }

  if(gs.mode == MODE_RUNNING){
    updateAliens(now);
    updateBullets(now);
  }

  // Display (langsamer = ruhiger)
  static uint32_t lastDisp = 0;
  if(now - lastDisp >= DISPLAY_TICK_MS){
    lastDisp = now;

    display.clearDisplay();
    if(gs.mode == MODE_IDLE) {
      drawStartScreen(now);
    } else if(gs.mode == MODE_GAMEOVER) {
      drawGameOver(now);
    } else if(gs.mode == MODE_WIN) {
      drawWin(now);
    } else {
      drawUI();
      drawAliens();
      drawBullets();
      drawShip(now);
    }
    display.display();
  }
}
