ehajo/arcade-machine/(commit log)

2026-03-03 status quo
    not working, all kap00t
    [Deckel.stp, Unterteil.stp, arcade-pcb.kicad_pcb, arcade-pcb.kicad_sch, bom.csv, controller-standard.kicad_pcb, controller-standard.kicad_sch, controller-tennis.kicad_pcb]
2026-03-06 alien with sound
    jetzt sogar in farbe und bunt ach ne, nur mit sound!
2026-05-15 aktueller stand
    [Arcade.3mf, Arcade_base.stp, Arcade_right.stp, Beschriftung_blank.stp, Bildschirm.stp, Deckel.stp, Unterteil.stp, arcade-pcb.kicad_pcb]
2026-05-21 Add ESP32-C3 release binaries
